sakura-madoromi/TetherLock/docs/design/v3-procurement-status.md

> 当前已升级为 **V3-purchased-specs-1**：M4×55电机、侧壁R16按钮、3mm绑带槽；霍尔和磁铁取消。以下是旧版记录，当前规格和未完成接口以[现购物料适配说明](v3-purchased-specs.md)及当前BOM为准。

# V3 plan1 采购资料与待解决项目

工程数据版本：V3-plan1.1；CAD指纹：`d1dc445e5ce543239a1012be095a35d1c04742943b300b049524b15deb2aeb14`。精确生成时间和数据指纹见`generated/v3/engineering/data.json`、CSV标题与蓝图标题栏。

主表：`hardware/v3/engineering/materials.json`；紧固件型号和数量从 `hardware/v3/cad/hardware.scad` 的配置导出。`docs/design/v3-bom.csv` 是生成后的完整CSV，含版本与指纹；不得手工改CSV数量。

设备装机估算 **215.95元**，采购整包 **274.50元**，工具与外置充电器 **178.00元**。2026-10-02已观察主控及单节电池座SKU报价并更新，其余主配置金额仍为估算；运费另计。外包打印仍待报价。可靠资料候选不能满足约100元目标，不能宣称已达预算。

## 2026-10-02 实际商品核查

按1套样机、寄云南个旧或蒙自核算；页面仅验证寄个旧。六项低价候选优惠前合计38.78元，单项运费共8元；整套条件替代情景装机109.73元、整包168.28元，其他零件报价和运费仍有缺口。新电芯候选亿纬25P平头2500mAh，11元寄个旧包邮；原DW01A保护切断可能低于其2.5V下限，须重新选型。稳压25×14.5×4.5mm、OLED25.2×26mm/1315及DRV8833红板均有适配或接线差异，不能视作原模型已适配。

具体SKU、公开尺寸/原理图、接线差异、各项目待核条件及省运费安排见 [采购核查记录](../reviews/v3-procurement-review-2026-10-02.md)、[逐项采购审计CSV](../reviews/v3-procurement-audit-2026-10-02.csv)。

## 已找到资料的候选

- 主控稳压候选 [Pololu S7V8F3 #2122](https://www.pololu.com/product/2122/)：输入2.7～11.8V、输出3.3V；裸板约11×17×3mm，可直接焊线。电池低电压时可用电流须按曲线/台架验证；无电池过放和反接保护。预算暂估75元，比原4元增加71元。

- 电机驱动候选 [Pololu DRV8833 #2130](https://www.pololu.com/product/2130)，[板尺寸图](https://www.pololu.com/file/0J1615/drv8833-dual-motor-driver-carrier-dimensions.pdf)：12.7×20.3mm；VM2.7～10.8V。裸板与装排针后的高度不能混用，出线/最高器件还须确认。当前CAD仍是旧15×20×7候选，不能把20.3mm板自动认定适配。

- [TI DRV5032](https://www.ti.com/lit/ds/symlink/drv5032.pdf)：ZE芯片电气条件已核对，但成品小板尚未找到满足安装条件的确定SKU；芯片尺寸不能当成板件尺寸。合盖检测仍须测触发、释放和锁扣可通过范围。

- [Apple 手机技术规格](https://support.apple.com/en-la/125091)和[官方配件尺寸图](https://developer.apple.com/download/files/accessories/dimensional-drawings/iphone-17-pro-max.pdf)用于尺寸参照。`hardware/v3/engineering/references.json`记录主体8.75mm、相机平台2.55mm与玻璃1.88mm，总厚13.18mm。该参照不计设备采购、打印数量或耗材。

## 未解决项目

- **motor**：已取得驰海M3丝杆厂家参考尺寸图及3V45/26型电气参数；对应淘宝SKU未定。45型额定200rpm/堵转≤0.95A、26型额定130rpm；须核对最大12.1mm径向尺寸、0.5螺距及低电池带载。主候选不得视为已验证商品。

- **bridge_board**：板长20.3mm超出旧20mm候选包络0.3mm，局部挡边和焊线空间待适配；人民币估算40元也超出原3元预算。禁止图纸显示已验证装配。

- **hall**：只核对了芯片电气属性，三片现成板件仍未选定。旧8×6/6×6小板不能当作商品尺寸；须补充模块或重新设计支架。

- **ties**：旧CAD绑带槽宽1.5mm；常见2.5mm绑带不适配，需窄带或局部扩槽。

- **battery_protection**：现有电池座实体为74×22×21总包络，没有单列保护板适配证据；不能把芯片面积当板件面积。

- **battery_connector**：配对端一起采购；旧小包络及额定电流尚未实测。不得自动把红线当成正确针位。

- **motor_bulk_cap**：模块现有去耦不能保证电机瞬态，按台架测量决定容量；独立电容安装包络待适配。

- **external_printing**：费用尚未报价，不以0元宣称免费；与设备耗材成本分开。

完整主表、89页机械/电气资料和27步组装指导已实现。未解决项按计划保留具体尺寸、预算或选型冲突；候选硬件包络不表示现货已适配，图纸和步骤禁止将其当作已验证装配。实物记录模板为 `docs/design/v3-physical-acceptance.csv`，测量栏为空。

2026-10-02用户要求改为公开资料核验：停止淘宝登录查询。报告补充五项不需登录的外币公开报价、完整模块核验表、保护参考电路及来源校验；人民币六项SKU观察值仍为同日历史记录，未知合单/蒙自运费未填0。M2嵌件与按钮无确定适配供货型号，已列为未解决。
