sakura-madoromi/TetherLock/docs/reviews/v3-procurement-current-2026-10-02.md

# 现实模块与价格核算：当前采购版 · 2026-10-02

1套样机；白色外壳；云南红河个旧或蒙自；先采购电气台架，紧固件及装壳物料后买。用户决定采用N20 M4×55、绿色无灯两脚无锁R16按钮，取消霍尔；2.5mm绑带槽已修改。仅公开资料及用户截图，不使用淘宝登录会话，不下单、不联系卖家。

本报告替代早前M3/霍尔/Pololu低价候选情景。历史报价保留历史身份；同芯片的不同板不能互相套尺寸、价格或电路。当前完整62行BOM逐项价格身份见[v3-procurement-current-audit-2026-10-02.csv](v3-procurement-current-audit-2026-10-02.csv)。

## 可核对的本次订单小计

截图12项的单价×数量合计恰好**¥81.51**，与底部“立即支付”一致；这不是支付凭证。虽然第三张底部还有“顺手买”入口，可见12项已经算到显示总额，不能据此猜测另有已选商品。

- 删除3颗霍尔：¥81.51−¥4.05=**¥77.46**。
- 面包板2→1、按钮2→1、SM成对线3→1：再省¥3.50+¥1.32+¥1.12=¥5.94，最低可见商品小计**¥71.52**。
- 2P排线截图优惠后¥1.76/m，划线价¥2.51/m，两米优惠差¥1.50。不依赖这项优惠时，减量预算**¥73.02**；保留原数量但删霍尔的预算**¥78.96**。

这里的“最少”仅适用于人工电气台架；若两块面包板和备件更方便，可保留。SM成对线1份只覆盖一个可拆接口，其他连接台架直焊/跳线；若需电机也可拆，要另留一份，增加¥0.56。没有自动操作用户购物车。

| 商品 | 原数量 | 最少台架数量 | 截图单价 | 最少小计 |
|---|---:|---:|---:|---:|
| MB-102 830孔面包板 | 2 | 1 | ¥3.50 | ¥3.50 |
| SM2P 20cm成对线 | 3 | 1 | ¥0.56 | ¥0.56 |
| 1S-4012A(3.7V)保护板 | 1 | 1 | ¥4.95 | ¥4.95 |
| 18650单节带线座 | 1 | 1 | ¥1.32 | ¥1.32 |
| R16-503绿色无灯两脚无锁 | 2 | 1 | ¥1.32 | ¥1.32 |
| DRV5032ZEDBZR裸芯片（取消） | 3 | 0 | ¥1.35 | ¥0.00 |
| DRV8833红板已焊排针 | 1 | 1 | ¥2.46 | ¥2.46 |
| TPS63020 3.3V模块 | 1 | 1 | ¥14.85 | ¥14.85 |
| 0.96寸白色4P OLED | 1 | 1 | ¥10.89 | ¥10.89 |
| ESP32-C3 SuperMini已焊排针 | 1 | 1 | ¥12.65 | ¥12.65 |
| 26AWG黑色2P排线1m | 2 | 2 | ¥1.76 | ¥3.52 |
| N20 M4×55 3V 150rpm带法兰螺母 | 1 | 1 | ¥15.50 | ¥15.50 |

优信原订单¥62.49，删霍尔后¥58.44，按上述减量为¥52.50；萨牛两米线¥3.52；德弘电机¥15.50。三店在原截图均显示包邮。地址未展开，未证明选择的是个旧还是蒙自，也未确认删减后包邮门槛。最终到手价为商品小计+修改后的实际运费+未购补件；未知运费不填0。退货运费险为可选项，不当作必购硬件费用。

## 还不在这个小计里的东西

截图没有展示18650电芯、独立单节锂电充电器、杜邦跳线、USB-C数据线、驱动电源端100µF≥10V电容。已有工具/线材可复用；未知价格暂不编造。三个机械到位开关、触发支架属于后续机构验证，不是当前已完成的检测子系统。不要为了买几毛钱补件再付一笔运费，优先同店并单；新增店铺只有货价节省超过新增运费及必要适配费用才值得拆单。

## 尺寸与电路核查结论

| 模块 | 已有证据 | 当前结论/剩余核对 |
|---|---|---|
| N20 M4×55 | 用户德弘尺寸图：M4、牙距0.7、轴55±1、截面12×10、轴偏置2.5 | 本体文字16+9与图15+9/24.5不一致，CAD取25mm保守包络；前视Ø3也与正文M4矛盾。150rpm负载定义/堵转电流/自锁仍待测。 |
| 配套法兰螺母 | 截图写“带法兰螺母”，没有尺寸 | 不是已核定AF7/Ø10/厚5。其他供应商有Ø22×12、四M3孔的M4联轴法兰件，不能自动套用，也不能把候选六角座当已适配。实际配套件须量尺寸和安装孔。 |
| R16-503两脚无锁 | 用户图Ø17.8、本体18.3、端子6、外端5.7；同系列供应商公开φ16安装 | CAD侧壁凹入候选孔Ø16.4；实际螺纹/螺母与3mm面板夹持待确认。常开按下闭合；不接LED电源。 |
| ESP32-C3 SuperMini已焊排针 | 确定采购型号与报价；Nologo公开参考原理图 | 实际板是否同版、排针总高和USB/3V3反灌未证明；先USB台架，装壳需量或去排针。 |
| TPS63020固定3.3V | 选项截图；TI芯片手册/参考电路 | 不能借用另一家25×14.5或Pololu尺寸。优信公开索引找到5V款，未得到本3.3V板完整图。EN/PS接法及低电量瞬态待核。 |
| DRV8833红板已焊排针 | 截图选择与TI芯片原理 | 不沿用Pololu的FLT/SLP端子和默认上拉。真实封装、板端STBY连通、限流、起动/堵转及板尺寸未核。PW持续额定低于PWP/RTY；不能用“2A峰值”证明持续能力。 |
| OLED 0.96白色4P | 截图所选规格和报价 | 不能套用之前另一店SSD1315/25.2×26尺寸；确认3.3V、I2C脚位、地址、控制器和PCB/排针高度。 |
| 1S-4012A(3.7V) | 截图选项明确3.7V | 公共搜索存在同名3.2V磷酸铁锂和3.7V锂离子版本；不凭型号猜保护芯片/电流。需核对所选板的过充/过放阈值、容差、恢复、B/P端和外形。 |
| 18650座与SM2P | 选项/报价；接口类型可区分 | 座含电芯/弹簧/出线尺寸待测。SM2.54并非原JST-SH1.0；对插极性、线径、接触电流与装壳包络待核。 |
| 2.5mm绑带/连续钢轴 | 当前CAD实体测试和用户规格 | 槽3mm且贯通；钢轴仍Ø2×180连续，买长棒切断。AB胶短轴拼接不能替代。 |

完整卖家板级原理图尚未取得。TI/Nologo参考电路是核对依据，不是证明所购板完全同版。当前逻辑计划保留GPIO0/1显示、GPIO3/4/5待选机械触点、GPIO6按钮、GPIO7/10驱动输入；真实丝印/焊盘须核对。电机独立支路，共地；首次USB主控调试不同时外供3V3，保护B−不旁路到系统地，保护板也不代替充电器。

## 当前整机估算与本次订单的区别

已将用户最新截图对应的主控、稳压、驱动、显示、座、保护板、接头、排线价格写入物料主表，替换旧候选价格；没有将旧Pololu板当作¥14.85的TPS63020。原主表装机估算¥208.37已变为**¥122.47**，整包估算**¥163.74**，均不含未知运费和外包打印费；工具及独立充电器仍为估算¥178.00，已有可复用。

这不是完整成品到手报价：机械耗材/电芯/工具仍有未报价项，打印耗材按旧用量估算；机械反馈数量当前为0，后续开关/支架费用未加入。屏幕、主控等有报价不等于装壳适配完成。不能用¥71.52台架小计宣称100元完整产品已达标。

## 公开来源与证据

- 用户截图：[订单1](../../assets/evidence/reviews/v3-current-procurement-evidence/s3if18a7.webp)、[订单2](../../assets/evidence/reviews/v3-current-procurement-evidence/p8f6gmau.webp)、[订单3](../../assets/evidence/reviews/v3-current-procurement-evidence/a80znaro.webp)；[按钮尺寸](../../assets/evidence/reviews/v3-purchased-specs-evidence/bw1v2lpe.webp)、[电机尺寸](../../assets/evidence/reviews/v3-purchased-specs-evidence/xv97n9y4.webp)。未保存账号资料或访问登录会话。
- [Finglai R16-503B](https://www.finglai.com/products/switches/push-buttons/DIA16-R/R16-503B.html)：φ16、复位(ON)-OFF同系列参考；其寿命/电流参数不能代替优信实物。
- [优信TPS63020 5V目录](https://www.yourcee.com/productinfo/875179.html)：只找到另一输出选项的公开索引，未取得3.3V所选板完整电路/尺寸。
- [Tempero M4 flange coupling nut](https://temperosystems.com.au/products/m4-flange-coupling-nut/)：不同供应商给22mm外径、12mm高度、四M3孔，且标用于N20 M4×55。仅用于指出螺母形态不唯一，未采用其外币报价或套入德弘型号。
- [TI DRV8833](https://www.ti.com/lit/ds/symlink/drv8833.pdf)、[TI TPS63020](https://www.ti.com/lit/ds/symlink/tps63020.pdf)、[Nologo主控参考电路](https://github.com/NologoTech/ESP32C3-Supermini/tree/main/Hardware)。

当前几何1148项通过，价格审计与CAD核验范围分开。实际法兰螺母、保护板参数、所选板包络/完整板图、机械开关与最终云南运费仍未证明。报告明确保留这些缺口；目前不把“现实模块规格全部核实”的目标标为完成。
