sakura-madoromi/TetherLock/docs/superpowers/plans/2026-10-01-v3-cad.md

# TetherLock V3 CAD Implementation Plan

> **For agentic workers:** Execute inline in the authorized workspace. Checkpoints below replace a separate execution handoff because the user explicitly requested CAD generation. No commit, branch mutation or publication is requested.

**Goal:** Deliver an inspectable V3 structural CAD prototype, printable part exports, complete provisional hardware envelopes, and reproducible geometry checks.

**Architecture:** New independent `hardware/v3/cad/` subtree. Offset M3 screw moves a nut carriage whose finger engages a laterally floating fork on a solid bolt. A keyed guide supports the bolt independently. An isolated battery compartment opens underneath the main lock box.

**Tech Stack:** OpenSCAD CLI, Python standard library, SVG/PNG previews.

**Spec:** `docs/design/v3-proposal.md`, current design baseline; unresolved acceptance items are tracked in `docs/design/v3-purchased-specs.md`.

## Global Constraints

- Closed overall envelope 240×120×55 mm including hinge.
- Target object envelope 185×95×40 mm and removal path.
- No external USB or internal charger; removable 18650 and separate charger.
- Unlock confirmation ≤15 seconds is a physical acceptance requirement, not proven by CAD.
- Approximately RMB 100 with a small overrun allowed; procurement prices checked later by user.
- Hardware that has no frozen SKU must be labelled provisional; no strength or manufacture-release claim.
- V3 is the only maintained CAD and export baseline; old version sources and exports are not part of the current tree.

## File boundaries

- `hardware/v3/cad/params.scad`: shared dimensions and assembly interfaces.
- `hardware/v3/cad/enclosure.scad`: shell, lid, battery cover, latch, retainers.
- `hardware/v3/cad/lock.scad`: module base, guide, solid bolt, floating drive, motor clamp.
- `hardware/v3/cad/electronics.scad`: removable electronics carrier and retainers.
- `hardware/v3/cad/hardware.scad`: provisional purchased part envelopes and fasteners.
- `hardware/v3/cad/assembly.scad`: part dispatch, assembled/open/exploded and printable views.
- `scripts/v3/export_verify.py`: fresh exports, topology, pairwise interference, motion, storage and negative controls.
- `docs/design/v3-cad.md`, `v3-bom.csv`: dimensions, assembly, print placement and unresolved hardware/physical checks.

## Task 1: Acceptance harness before CAD

- [x] Write the export/verification entry point with an assertion that the assembly source exists.
- [x] Run `python3 scripts/v3/export_verify.py --quick` and observe the missing-V3-source failure.
- [x] Define real exported mesh assertions: positive volume, closed edges, connected exterior surface; closed assembly within target envelope; zero unplanned collisions.

## Task 2: Mechanical modules

- [x] Implement shared parameters and independent part dispatch.
- [x] Use an 8 mm OD hinge inside the closed envelope with fixed rear header and relief for moving knuckles.
- [x] Implement removable battery maintenance cover, fixed compartment isolation, and hardware component extraction clearance.
- [x] Implement latch T head, inside retainer, replaceable neck, and solid 6 mm bolt with a keyed guide and floating drive connection.
- [x] Export every part using `python3 scripts/v3/export_verify.py --quick`; fix actual collision/connectivity failures before adding previews.

## Task 3: Complete assembly and provisional hardware

- [x] Add motor, threaded shaft, captive nut, cell/holder, ESP, OLED, regulated power and H bridge, three detection envelopes, button, acrylic, hinge pin and fasteners.
- [x] Add removable electronics supports with fasteners and wire routing holes; no floating clips.
- [x] Check actual assembly pairs at release and locked endpoints and intermediate travel. Check a 0.25 mm loaded-bolt displacement does not contact the screw/drive finger; a 0.35 mm displacement must contact its guide.

## Task 4: Export, motion and documentation

- [x] Run `python3 scripts/v3/export_verify.py` for fresh source exports, full closed-pair checks, opening samples to 105°, object insertion/removal and battery extraction.
- [x] Run negative controls for opening while locked and the geometry checker against an intentionally obstructed pose; record evidence rather than silently ignore errors.
- [x] Render assembled, open, exploded and lock close-up PNG from the same assembly file.
- [x] Write BOM, assembly and print instructions, dimensions and limits. Include minimum printer bed footprint and physical qualification checks.
- [x] Check docs, source/export manifest and V2 hashes; deliver as a structural prototype with the specific validation scope.

## Completion evidence

- Main fresh export run: 1,034 checks, zero failures (`generated/v3/verification.json`).
- Independent review additional drive-group checks: 10, zero failures; reproducible via `scripts/v3/verify_review.py`.
- 21 printable STL types / 23 assembled printable pieces; exact closed bounds 240×120×55.
- All 23 preserved V2 source/export hashes unchanged.
- Structural prototype only: printer supports, purchased SKUs, actual tolerances/strength, electronics/firmware and loaded low-voltage unlock ≤15 s still need physical qualification.
