sakura-madoromi/TetherLock/docs/superpowers/plans/2026-10-01-v3-viewer.md

# V3 Preview Workbench Implementation Plan

User explicitly requested direct implementation without brainstorming. Execute inline in the authorized workspace; no commit or publication. Existing historical HTML and V3 CAD remain intact.

**Goal:** A polished local Vite workbench using actual verified V3 geometry, with reliable motion and reusable preview/engineering exports.

**Architecture:** Vanilla JavaScript modules with Three.js, generated public assets and provenance manifest. Keep UI, CAD transforms, rendering, drawing projection and file export separate. Engineering drawings use actual transformed mesh geometry; they are reference projections, not manufacturing drawings or a replacement for CAD.

**Files:** root `package.json`, `vite.config.js`; `viewer/index.html`, `apps/workbench/src/{main,scene,state,drawing,exports,icons}.js`, `apps/workbench/src/style.css`; `scripts/v3/viewer_assets.py`; `tests/workbench/{state,drawing}.test.js`, `tests/workbench/browser.mjs`; `docs/design/v3-viewer.md`.

- [x] Write and run failing motion/transform/drawing tests. Catch lid opening before bolt release, wrong hinge axis, and incorrect measured drawing dimensions.
- [x] Generate release-pose assets from verified CAD exports and metadata; include source SHA256 and real hardware/fastener geometry. Refuse stale verified sources.
- [x] Implement scene: Z-up CAD coordinates, fixed hinge pivot, Y-only drive stroke, distinct explosion offsets, part selection/visibility/isolation, clipping, rulers and framing.
- [x] Build responsive workbench UI: assembly/engineering modes, part browser, motion timeline, material/camera presets, selection inspector and export controls.
- [x] Implement actual mesh-derived orthographic SVG drawing with sampled depth visibility and measured dimensions; PNG and browser print/PDF. Label current pose, visible-part extent and scale.
- [x] Implement clean 2K/4K PNG including transparent background, multi-view ZIP, WebM movement recording, GLB in meters, saved views and JSON view settings.
- [x] Run node tests, Vite production build and real Chromium browser checks: asset load, picking, motion, clipping, drawings, downloads, recording, mobile layout and offline/static build.
- [x] Request independent code review, fix material findings, document commands/limits and leave local preview running. Package static build and verification evidence.

Validation evidence: `generated/v3/viewer-verification.json`, real downloaded examples in `generated/v3/viewer-static/`, and `docs/reviews/v3-viewer-review-2026-10-01.md`. Static bundle includes all models and downloads with relative URLs. Browser regressions also cover rounded silhouettes, damaged camera imports, pose changes during exports, recording interruptions, and narrow-screen framing.
