sakura-madoromi/TetherLock/docs/design/v3-plan1-delivery.md

> 当前已升级为 **V3-purchased-specs-1**：M4×55电机、侧壁R16按钮、3mm绑带槽；霍尔和磁铁取消。以下是旧版记录，当前规格和未完成接口以[现购物料适配说明](v3-purchased-specs.md)及当前BOM为准。

# plan1 工程资料交付记录

本次已交付V3-plan1.1工程工作台、CAD/STL和机械/电气资料。采购与局部模块适配按plan1 §2.3的条件分支处理：完整现货包络、预算或检测条件不能确认时，输出具体冲突并保持未解决状态。此交付不等于全部模块已选定或实物已经合格。

| 计划范围 | 已交付内容与证据 |
|---|---|
| §2.1 共用数据 | engineering目录主表；44个产品对象、69行物料、35个稳定紧固连接；数量、特征与引用审计 |
| §2.2 无窗垫结构 | 内栅接触面Z47.4～50.5、固定耳Z47.4～49.9；149×82×1.5窗片；栅窗31项检查 |
| §2.3 模块采购 | 主候选、资料来源、关键条件及8项具体未解决项目；见v3-procurement-status.md；未知包络没有伪装为已适配 |
| §3.1 尺寸参照 | 独立本地手机/虚构卡模型与开关；图片/录制按可见状态；GLB选择包含参照；制造资料排除参照 |
| §3.2 物料 | 完整/采购/打印/工具四种CSV；搜索、分类、数量切换、费用分组与跨页面链接 |
| §3.3～3.5 蓝图 | 41个主题扩展88页；固定制造姿态、真实闭合截面、CAD名义孔位/台阶、热熔方向/深度/余料、打印方向/支撑/备件 |
| §3.6 电气 | 电源/逻辑GPIO/端子/线束/台架资料，38条逐线记录；实际模块焊盘与接头物理针序保留收货确认条件 |
| §3.7 导出 | 实际SVG、3840px PNG、A3 PDF、整套ZIP；本地可嵌入中文字体；1:1亚克力SVG/DXF与100mm校验线 |
| §4 组装指导 | 22装配+5维护步骤；独立场景/相机、已验证路径与操作示意区分、手动检查、版本进度/旧记录/JSON/重置/禁用存储回退 |
| §5 验证和交付 | 当前源码几何、数据、浏览器及包指纹证据；静态HTTP子目录离线使用；实物记录模板保持空白 |

CAD名义几何检查通过1078项整机、31项栅窗、81项铰链/霍尔、10项附加驱动、33项参照及6项连续安装路径检查。整盖/锁驱动的既有采样检查与连续安装扫掠分别标识；几何证据不证明保持力、运动寿命或电气性能。

工程资料审计通过458项检查，71条真实剖面路径闭合。桌面浏览器四个套件分别通过19、7、7、21组；静态HTTP子目录两套件分别通过19、21组。浏览器报告包含当前源指纹。19项单元测试通过。实际输出文件及三个ZIP的逐文件一致性以当前三个交付包内的清单为准。

设备装机估算216.95元、整包采购275.50元、工具与外置充电器178元；均非报价，外包打印另待报价。约100元目标未达。电机、驱动板、三片霍尔板、绑带、电池保护、配对接头、补充电容与外包打印仍为未解决项目，具体冲突见采购状态文档及BOM。

用户可从同一份资料找到采购规格、打印文件、尺寸依据、装配顺序、逐步检查和待测项目。实际模块适配仍需供货尺寸/实物；电气引脚是带板型核对条件的逻辑接线要求。实物强度、霍尔触发/释放、低电压、开合寿命与≤15秒开锁没有通过声明。控制固件属于后续独立任务。
