sakura-madoromi/TetherLock/docs/reviews/v3-viewer-review-2026-10-01.md

# V3 工作台独立代码审查

2026-10-01，按 requesting-code-review 技能由只读审查代理完成。审查对象为当前未提交的 `apps/workbench/src`、资源生成脚本、Vite 配置与测试；没有修改 CAD 和历史预览。最终结论：没有遗留的严重或重要缺陷，可以交付。

| 发现 | 修复与验证 |
| --- | --- |
| 相机导入接受空数组，使三维坐标变成 undefined | 三元有限向量、有效距离、缩放和投影范围校验；修改姿态前验证；单元与浏览器回归 |
| 平滑圆角/圆柱没有锐边，工程图丢失外轮廓 | 增加随视向变化的邻面轮廓；覆盖平行视线退化情况；两种圆柱分段角度回归 |
| 五视图导出期间允许修改姿态，导致图片与配置不一致 | 固定姿态、镜头、选件、画布交互；覆盖书签和局部事件入口；浏览器中途改栓行程被阻止 |
| 录制中切工程视图/手动姿态/暂停/加载书签停止运动，却不停止录像 | 录制期间保留镜头操作，防止这些操作中断完整周期；浏览器确认仍自动结束并生成 WebM |
| GLB 测试只认 scale 字段，误报正确的 matrix 缩放 | 检查根节点缩放矩阵或 scale，并核对 base_box 的 0.24×0.12×0.055 m 包络 |
| 桌面切换到窄屏时沿用相机距离，模型部分裁出画面 | 显著缩窄视口时重新构图，隐藏画布和图片导出时跳过；浏览器验证闭合包络八个角投影完整留在390 px画面 |

审查另核对了 CAD 的 +X 铰链轴、+Y 锁栓行程、储物验收块位置、工程视图真实投影尺寸、源文件指纹链条和 GLB 米单位。审查代理独立运行最新单元测试，9/9 通过。实际浏览器交互和下载文件由主代理验证，结果见 `generated/v3/viewer/browser-results.json`。

实物强度、摩擦、电机扭矩、开锁时间和供应商尺寸属于后续样机验证；本次工作台不将几何动画作为这些性能的验证依据。
