sakura-madoromi/TetherLock/docs/reviews/v3-window-grille-review-2026-10-01.md

# V3 双层同色防护栅窗独立审查

按 requesting-code-review 技能，由只读审查代理检查 `hardware/v3/cad` 的新栅窗及资源生成链条。用户已确认内外双栅夹窗片，内外栅栏与外壳同色同耗材。结论：未发现关键或重要结构缺陷，本次CAD变更可接受。

| 独立检查 | 证据 |
| --- | --- |
| 上下软垫实际实体支承 | 将软垫投影移入相邻栅栏0.3 mm后，差集为空 |
| 四耳硬限位 | +0.2 mm探针交集体积约75.591 mm³，对应接触面积约377.96 mm² |
| 网格可打印性 | 顶盖与内栅均单连通、封闭，无非流形边与退化三角；内栅打印Z=0～2.5 |
| 沉头螺钉与盲孔 | 头朝盒内、杆朝+Z；杆端53.4、进入导孔3.5、孔底余量0.8、外表面余料0.8；不碰亚克力 |
| 内侧工具与维护路径 | 主盖105°时4 mm工具通道可接近；栅窗组向内移出80 mm无碰撞 |
| 预览与生成件 | 新内栅/窗片/软垫均随盖运动；内外栅与壳同色；过期四压片网格会移除 |

30项栅窗专项检查通过，见 `generated/v3/window/verification.json`。独立探针保存在本审查记录旁的 `v3-window-grille-evidence/`。主代理另执行完整整机几何验证、附加驱动检查和浏览器回归；最终证据以更新后的生成报告为准。

本结论针对名义几何。软垫压缩量、打印螺纹保持力、栅条抗弯、窗片抗冲击和实物开锁性能仍需样件验证。
