sakura-madoromi/TetherLock/docs/superpowers/plans/2026-10-01-plan1.md

# V3 Plan 1：初始计划索引

本文件原先保存了与工程工作台实施计划大段重复的初始任务清单。完整的目标、约束、实现步骤和后续完成状态统一维护在 [工程工作台实施计划](2026-10-01-plan1-engineering-workbench.md)。

初始计划中的任务尚未勾选；后续实施计划增加了完成状态与未解决限制，两者不是同一次验收。需要引用初始措辞时，使用[已发布基线中的冻结原文](https://github.com/sakura-madoromi/TetherLock/blob/95086fa086710571b39ede804c02a39de307ba05/docs/superpowers/plans/2026-10-01-plan1.md)。本次目录治理的完整本地备份也保留了原文。
