sakura-madoromi/TetherLock/docs/reviews/v3-hinge-hall-evidence/continuous_pin_service.scad

include <../../../hardware/v3/cad/assembly.scad>
view="metadata";
lid_angle=105; intersection(){xrod(-357,hinge_y,hinge_z,2,680);named("pin_service_surround");}
