sakura-madoromi/TetherLock/docs/reviews/v3-hinge-hall-evidence/keepers_pin_nominal.scad

include <../../../hardware/v3/cad/assembly.scad>
view="metadata";
intersection(){hinge_pin();hinge_guard(-1);}
