sakura-madoromi/TetherLock/docs/reviews/v3-hinge-hall-evidence/keepers_pin_radial_front_021.scad

include <../../../hardware/v3/cad/assembly.scad>
view="metadata";
intersection(){translate([0,.21,0])hinge_pin();union(){hinge_guard(-1);hinge_guard(1);}}
