sakura-madoromi/TetherLock/docs/reviews/v3-hinge-hall-evidence/keeper_driver.scad

include <../../../hardware/v3/cad/assembly.scad>
view="metadata";
lid_angle=105; keeper_tool_conflicts();
