sakura-madoromi/TetherLock/docs/reviews/v3-hinge-hall-evidence/base_box.scad

include <../../../hardware/v3/cad/assembly.scad>
view="metadata";
named("base_box");
