sakura-madoromi/TetherLock/docs/reviews/v3-hinge-hall-evidence/base_installed_extra.scad

include <../../../hardware/v3/cad/assembly.scad>
view="metadata";
difference(){base_box();let($print_bores=true)base_box();}
