sakura-madoromi/TetherLock/docs/reviews/v3-hinge-hall-evidence/base_print_extra.scad

include <../../../hardware/v3/cad/assembly.scad>
view="metadata";
difference(){let($print_bores=true)base_box();base_box();}
