sakura-madoromi/TetherLock/docs/reviews/v3-hinge-hall-evidence/hinge_guard_right.scad

include <../../../hardware/v3/cad/assembly.scad>
view="metadata";
named("hinge_guard_right");
