sakura-madoromi/TetherLock/docs/reviews/v3-hinge-hall-evidence/item_post_clearance.scad

include <../../../hardware/v3/cad/assembly.scad>
view="metadata";
intersection(){base_box();named("item");}
