sakura-madoromi/TetherLock/docs/reviews/v3-hinge-hall-evidence/keeper_insert_coupon.scad

include <../../../hardware/v3/cad/assembly.scad>
view="metadata";
print_part("keeper_insert_coupon");
