sakura-madoromi/TetherLock/docs/reviews/v3-hinge-hall-evidence/left_cheek_slice.scad

include <../../../hardware/v3/cad/assembly.scad>
view="metadata";
intersection(){hinge_guard(-1);translate([-109.1,-56,50])cube([2,2,2]);}
