sakura-madoromi/TetherLock/docs/reviews/v3-hinge-hall-evidence/lid.scad

include <../../../hardware/v3/cad/assembly.scad>
view="metadata";
named("lid");
