sakura-madoromi/TetherLock/docs/reviews/v3-hinge-hall-evidence/lid_installed_extra.scad

include <../../../hardware/v3/cad/assembly.scad>
view="metadata";
difference(){lid();let($print_bores=true)lid();}
