sakura-madoromi/TetherLock/docs/reviews/v3-hinge-hall-evidence/lid_print_extra.scad

include <../../../hardware/v3/cad/assembly.scad>
view="metadata";
difference(){let($print_bores=true)lid();lid();}
