sakura-madoromi/TetherLock/docs/reviews/v3-hinge-hall-evidence/right_cheek_slice.scad

include <../../../hardware/v3/cad/assembly.scad>
view="metadata";
intersection(){hinge_guard(1);translate([73.4,-56,50])cube([2,2,2]);}
