sakura-madoromi/TetherLock/docs/reviews/v3-hinge-hall-evidence/window_insert_coupon.scad

include <../../../hardware/v3/cad/assembly.scad>
view="metadata";
print_part("window_insert_coupon");
