sakura-madoromi/TetherLock/docs/reviews/v3-window-grille-evidence/four_stop_contact.scad

include <../../../hardware/v3/cad/assembly.scad>
view="metadata";
intersection(){lid();translate([0,0,.2])window_grille();}
