sakura-madoromi/TetherLock/docs/reviews/v3-window-grille-evidence/inner_pad_fully_supported.scad

include <../../../hardware/v3/cad/assembly.scad>
view="metadata";
difference(){translate([0,0,-.3])window_pad_bottom();window_grille();}
