sakura-madoromi/TetherLock/docs/reviews/v3-window-grille-evidence/window_fasteners_in_pane.scad

include <../../../hardware/v3/cad/assembly.scad>
view="metadata";
intersection(){acrylic();lid_fasteners();}
