sakura-madoromi/TetherLock/docs/reviews/v3-window-grille-evidence/window_install_minus80.scad

include <../../../hardware/v3/cad/assembly.scad>
view="metadata";
lid_angle=105;window_raise=-80;intersection(){named("window_install");named("window_service_surround");}
