sakura-madoromi/TetherLock/(list of files, cad)

Other CAD files:
assets/cad/v3/assembly/base_box.stl
assets/cad/v3/print/fit_gauge.stl
assets/evidence/reviews/v3-hinge-hall-evidence/hinge_guard_left.stl
assets/evidence/reviews/v3-window-grille-evidence/blind_roof.stl
assets/cad/v3/assembly/battery_hatch.stl
assets/cad/v3/print/window_grille.stl
assets/evidence/reviews/v3-hinge-hall-evidence/keeper_insert_coupon.stl
assets/evidence/reviews/v3-window-grille-evidence/four_stop_contact.stl
assets/cad/v3/assembly/window_grille.stl
assets/cad/v3/print/fit_bar.stl
assets/evidence/reviews/v3-hinge-hall-evidence/base_box.stl
assets/cad/v3/assembly/acrylic.stl
assets/cad/v3/print/hinge_bore_coupon.stl
assets/evidence/reviews/v3-hinge-hall-evidence/item_post_clearance.stl
assets/cad/v3/assembly/esp.stl
assets/cad/v3/print/esp_clip.stl
assets/evidence/reviews/v3-hinge-hall-evidence/right_cheek_slice.stl
assets/cad/v3/assembly/oled.stl
assets/cad/v3/print/electronics_tray.stl
assets/evidence/reviews/v3-hinge-hall-evidence/left_cheek_slice.stl
assets/cad/v3/assembly/upper_clip.stl
assets/cad/v3/print/lock_base.stl
assets/evidence/reviews/v3-hinge-hall-evidence/window_insert_coupon.stl
assets/cad/v3/assembly/fasteners_fixed.stl
assets/evidence/reviews/v3-hinge-hall-evidence/lid.stl
assets/cad/v3/assembly/upper_deck.stl
assets/cad/v3/print/latch_retainer.stl
assets/evidence/reviews/v3-hinge-hall-evidence/hinge_guard_right.stl
assets/cad/v3/assembly/lid.stl
assets/cad/v3/print/lid.stl
assets/evidence/reviews/v3-hinge-hall-evidence/keeper_direct_lift.stl
assets/cad/v3/assembly/hinge_guard_right.stl
assets/cad/v3/print/insert_coupon.stl
assets/evidence/reviews/v3-hinge-hall-evidence/base_print_extra.stl
assets/cad/v3/assembly/fasteners_lid.stl
assets/cad/v3/print/latch.stl
assets/evidence/reviews/v3-hinge-hall-evidence/lid_print_extra.stl
assets/cad/v3/print/guide_cap.stl
assets/evidence/reviews/v3-hinge-hall-evidence/keeper_lift_half_steps.stl
assets/cad/v3/assembly/motor_pads.stl
assets/cad/v3/print/window_insert_coupon.stl
assets/evidence/reviews/v3-hinge-hall-evidence/keeper_half_steps.stl
assets/cad/v3/assembly/inserts_lid.stl
assets/cad/v3/print/hinge_guard_right.stl
assets/cad/v3/assembly/electronics_tray.stl
assets/cad/v3/print/keeper_insert_coupon.stl
assets/cad/v3/assembly/guide_cap.stl
assets/cad/v3/print/upper_clip.stl
assets/cad/v3/assembly/latch_retainer.stl
assets/cad/v3/assembly/bridge_board.stl
assets/cad/v3/print/upper_deck.stl
assets/cad/v3/assembly/hinge_guard_left.stl
assets/cad/v3/print/oled_bridge.stl
assets/cad/v3/assembly/battery_connector.stl
assets/cad/v3/assembly/esp_clip.stl
assets/cad/v3/print/hinge_guard_left.stl
assets/cad/v3/assembly/inserts_fixed.stl
assets/cad/v3/print/base_box.stl
assets/cad/v3/assembly/battery_holder.stl
assets/cad/v3/print/battery_hatch.stl
assets/cad/v3/assembly/button.stl
assets/cad/v3/print/motor_clamp.stl
assets/cad/v3/assembly/oled_bridge.stl
assets/cad/v3/assembly/hinge_pin.stl
assets/cad/v3/assembly/fasteners_drive.stl
assets/cad/v3/assembly/lock_base.stl
assets/cad/v3/assembly/latch.stl
assets/cad/v3/assembly/motor.stl
assets/cad/v3/assembly/board_pads.stl
assets/cad/v3/assembly/motor_clamp.stl
assets/cad/v3/assembly/power_board.stl
assets/cad/v3/assembly/bolt.stl
assets/cad/v3/assembly/drive_nut.stl
assets/cad/v3/assembly/nut_cap.stl
assets/cad/v3/assembly/nut_carriage.stl
assets/cad/v3/print/bolt.stl
assets/cad/v3/print/nut_cap.stl
assets/cad/v3/print/nut_carriage.stl
