sakura-madoromi/TetherLock/docs/validation/product-render.md

# TetherLock V3 产品展示渲染

白色外壳，浅灰摄影棚背景。静态图为 3840×2160 PNG；动画为 1920×1080 VP9 WebM，包含实际解码帧数和时长记录。

## 静态图

- `01-closed-hero.png`：闭合产品主视觉
- `02-open-with-phone-card.png`：开盖展示手机与银行卡尺寸参照
- `03-open-top-layout.png`：开盖俯视布局
- `04-hinge-and-pin.png`：铰链与销轴背面视角
- `05-exploded-assembly.png`：分层爆炸总装
- `06-internal-mechanism-xray.png`：X射线内部机构展示
- `07-grille-window-detail.png`：栅窗与亚克力细节
- `08-oled-and-button-detail.png`：屏幕与按键细节

## 动画

- `09-opening-cycle-1080p.webm`：退栓、开盖停留、闭盖与上锁的完整循环。
- `10-open-close-detail-1080p.webm`：分别展示开盖和闭盖动作。

模型来自 V3 CAD 工作台；手机与虚构银行卡作为独立尺寸参照显示。动画用于产品动作展示。

## 输出归属

以上图像、动画和展示 ZIP 属于生成产物，默认输出到 `generated/v3/product-render/` 并忽略。需要长期保存的验收证据显式归档到 `assets/evidence/`，不要提交整个渲染目录。
