sakura-madoromi/TetherLock/docs/reviews/v3-cad-validation-repair-list-2026-10-02.md

# V3 CAD 验证与修复清单

日期：2026-10-02
对象：`hardware/v3/cad/*.scad` 当前版本；CAD 指纹 `d1dc445e5ce543239a1012be095a35d1c04742943b300b049524b15deb2aeb14`。
范围：几何、装配、运动净空、打印姿态及外购件包络。此文件记录待办；本轮未修改 CAD。

## 结论

当前名义几何没有复现出实体网格错误或已建模零件的明确碰撞：整机新鲜导出验证 **1078 项、0 失败**；栅窗 **31 项、0 失败**；铰链/霍尔 **81 项、0 失败**；独立驱动运动复核 **10 项、0 失败**；参照件包络 **33 项、0 失败**。组装指导中六条刚体安装/维护路径以 Minkowski 薄段扫掠检查，**6 项、0 失败**。当前工程数据审计 **458 项、0 失败**，包含 **71 条闭合剖面路径**。

这说明当前名义网格和列出的检查姿态自洽，不证明未定型号外购件适配，也不证明 FDM 首件强度、孔位配合、霍尔触发或带载开锁合格。整盖 0～105°、锁驱动行程及若干组件装入仍以离散姿态检查；连续安装扫掠的六项结果不覆盖这些整机运动。

## 待处理清单

下表状态均为“待处理”，没有在本轮实施修改。P1 表示冻结采购/装配版 CAD 前需关闭；P2 表示首件打印或机械定版前需关闭；P3 表示可在首件后依测量结果修订。

| ID / 优先级 | 发现与证据 | 建议修复或关闭方式 | 验收条件 |
|---|---|---|---|
| CAD-R01 / P1 | **N20 电机包络没有对应确定 SKU。** [electronics.scad](../../hardware/v3/cad/electronics.scad) 用 12×26×10 mm 电机块和 33.6 mm 轴长；[lock.scad](../../hardware/v3/cad/lock.scad) 的电机托槽、U 槽和压板依赖该包络。它们是候选尺寸，不是收货件尺寸。 | 采购前确认电机外形图、轴/丝杠长度、端子和线材出线、启动/堵转电流；按实物更新电机窝、压板、轴承/轴向限位及走线空间。 | 收货件尺寸及端子包络进入 CAD；退栓与闭锁端点、14 mm 全行程、105° 开盖均无干涉，驱动件可按指导装入并拆出。 |
| CAD-R02 / P1 | **DRV8833 候选与当前简化块不一致。** [hardware.scad](../../hardware/v3/cad/hardware.scad) 将 `bridge_board` 建成 15×20×7 mm。Pololu #2130 厂图标出 PCB 外形 12.7×20.3 mm，板边公差 ±0.3 mm；当前占位块没有说明板边、器件高度、焊点和导线包络。[厂家尺寸图](https://www.pololu.com/file/0J1615/drv8833-dual-motor-driver-carrier-dimensions.pdf) 当前支托垫按15×20 mm绘制，局部挡边、压条和线束空间尚未按该板确认。20.3 mm 比旧的20 mm占位长度多0.3 mm；这是包络差异，现有资料不足以断言整个托盘必然碰撞。 | 冻结驱动板 SKU 和安装方向；将 PCB、最高器件、焊线/排针和弯线半径分别建模，复核托垫、止挡、上层压条及接线可达性。若保持该候选，给 20.3 mm 边长和边缘公差留出装配间隙。 | 用含实物最大包络的 CAD 交集/装入检查通过；插入、固定、拔出和接线均有明确路径，压条能实际限位而不压器件/焊点。 |
| CAD-R03 / P1 | **三处霍尔板均无确定成品板尺寸。** 当前 [electronics.scad](../../hardware/v3/cad/electronics.scad) 的退栓/闭锁板为8×6×1.3 mm，外盖板为6×6×1.8 mm；这些小板包络尚未对应可采购 SKU。铰链/霍尔探针还表明锁舌在0.3°样本无干涉、0.4°样本已干涉，单独的合盖接近信号不能证明锁扣可通过。 | 选择三个实际传感器板件或明确采用裸芯片并设计 PCB；按封装、敏感面、焊盘/导线和胶垫重画座体。让传感阈值与锁舌可通过角度/缝隙共同验收，必要时调整磁铁/传感器位置或增加机械到位检测。 | 三个实际板件完整包络可安装、维护且导线不入运动区；实测合盖报到范围严格落在锁舌无阻通过范围内，并留有打印误差余量。 |
| CAD-R04 / P1 | **绑带槽只有1.5 mm。** [electronics.scad](../../hardware/v3/cad/electronics.scad) 的两条槽为1.5 mm；当前采购说明指出常见2.5 mm绑带不适配。 | 明确采购与装配使用的带宽；若用2.5 mm带，调整槽宽/圆角并检查托盘剩余截面；若保留1.5 mm，BOM 固定窄带规格。 | 实物绑带可穿入并锁紧，槽边无割带/开裂，带扣与相邻电路板及线束不冲突。 |
| CAD-R05 / P1 | **电池保护板、配对接头及电机补充电容没有完整安装包络。** 电池座目前只是 [hardware.scad](../../hardware/v3/cad/hardware.scad) 中的74×22×21 mm总包络；接头是4.3×5×5 mm占位；没有独立保护板及补充电容实体/安装位。 | 选定保护板与电池接头配对件并核对额定电流、极性、封装和线材弯曲；按瞬态台架测量决定是否加电机电容，再安排支架、绝缘、固定和线束通道。 | 所有件以实物最大包络进入 CAD；电池可取出，接头极性可检验，线束避开铰链/锁驱动，电容与保护板不会挤压储物或结构件。 |
| CAD-R06 / P2 | **板件压条名义留有0.3 mm游隙，实际保持力未知。** ESP占位最高Z=14.5，`esp_clip`底面Z=14.8；驱动板占位顶Z=27.3，`upper_clip`底面Z=27.6。名义各留0.3 mm，板件处于下方软垫上；这不构成名义干涉，但没有证明实际板件受压或受振动约束。 | 实物到手后核对 PCB/器件高度、软垫压缩量与压条螺钉止点；按需要调整压条高度或加入有规格的压垫。 | 板件可装拆，无器件/焊点受压；在预定搬运/开合工况下不窜动，连接器和维护针脚保持可达。 |
| CAD-R07 / P2 | **热熔铜螺母邻近的薄壁强度尚未实测。** 独立几何复核读得端盖/电池螺母座最小侧壁约1.375 mm，窗座上方余料1.1 mm；当前试块用于检验该区域，但没有热装、保持力或复拆实测。 | 先按同材质、同方向打印相应嵌件试块并记录热装深度/裂纹/保持力；失败时再增壁厚、扩大承座或调整螺母规格，并重检外形和净空。 | 试块热装和复拆无裂纹、变形或嵌件松脱；确认后的尺寸回填 CAD 并复跑相关实体、工具及窗片净空检查。 |
| CAD-R08 / P2 | **整盖开合与驱动扫掠仍是离散验证。** `export_verify.py` 对盖角使用1°步长并加0.25°/0.5°近闭合点；驱动全行程亦按离散位置检查。薄小碰撞或中间姿态碰撞可能落在采样之间。 | 增加对盖—底壳、盖—锁舌/电路、驱动件—导轨/螺钉等关键运动的连续扫掠或保守 Minkowski 区间检查；对极小净空保持可解释的体积阈值。 | 连续扫掠通过，或每段最小间隙由有界算法证明；故意加入的碰撞负对照能被检查器检出。 |
| CAD-R09 / P2 | **整件外壳打印需要专用平台与切片确认。** 底壳打印平面约240×120 mm，正好等于名义外形；打印说明要求另留裙边/夹具，不能默认在220×220 mm平台上打印。桥接/悬垂说明当前是文字核对项，没有本机切片或首件证据。 | 用目标打印机的有效打印区域、夹具/裙边及禁区实际切片；标记需要支撑的位置、拆支撑通道与桥接失败判据。若用户设备无余量，评估局部结构改版或外包打印，不缩放整机。 | 切片轮廓含必要边缘余量且不触碰机器禁区；首件隔仓、轴孔、锁座和薄壁支撑清理后尺寸与维护路径合格。 |

## 当前已通过的检查

- `scripts/v3/export_verify.py`：全量新鲜导出，1078 项通过，0失败；29种打印件网格闭合/单连通并落床，闭合总装外包络240×120×55 mm。该脚本对整盖运动采样，不是连续扫掠证明。
- `scripts/v3/verify_window.py`：31项通过；窗片、双栅层次、四耳、沉头与离散安装位置。
- `scripts/v3/verify_hinge_hall.py`：81项通过；端盖保持、销轴服务路径及名义霍尔安装几何。磁触发/释放不在 CAD 检查之内。
- `scripts/v3/verify_review.py`：10项通过；驱动组离散位置复核。
- `scripts/v3/verify_references.py`：33项通过；手机/银行卡参照件净空及显示模型尺寸。
- `scripts/v3/verify_assembly.py`：6项通过；钢销、两端盖、内栅/窗片的连续直线服务路径。
- `scripts/v3/verify_engineering.py`：458项通过；数据/特征/接线/步骤引用及71条真实剖面闭合路径。

除历史基线目录外，上述当前报告记录的 CAD 源文件指纹均与工作区一致。当前 CAD 指纹也与 `generated/v3/engineering/data.json` 一致。复跑入口和报告： [整机结果](../../generated/v3/verification.json)、[窗栅结果](../../generated/v3/window/verification.json)、[铰链/霍尔结果](../../generated/v3/hinge-hall/verification.json)、[参照件结果](../../generated/v3/references/verification.json)、[连续装配路径结果](../../generated/v3/assembly-paths/verification.json)、[工程数据审计结果](../../generated/v3/engineering-verification.json)。

## 不属于本清单的验收声明

Pololu #2130 的官方尺寸图支持本表关于其板宽/板长及边缘公差的对照；最终安装仍以实际采购板和焊线为准。[DRV8833 Carrier 尺寸图](https://www.pololu.com/file/0J1615/drv8833-dual-motor-driver-carrier-dimensions.pdf)。外包打印报价是采购事项，不是 CAD 缺陷。强度、寿命、实际霍尔磁场/阈值、电源瞬态及≤15秒带载开锁均须在样机/台架阶段测量；当前清单不把它们写成已经通过，也不以几何通过替代实测。
