sakura-madoromi/TetherLock/docs/maintenance/validation.md

# 目录治理与 Git/LFS 迁移验收

验证日期：2026-10-04。代码和资源均在原工作区及独立干净检出中检查；干净检出通过本地 Git remote 的 LFS 传输下载对象，没有复制旧 `node_modules`、应用 public、Cargo target 或 Dart 配置。

## 当前资源与提交边界

- 必要二进制集中到 `assets/`：126 个 LFS 文件，约 111.51 MiB；规范二进制不存在相同 SHA-256 的重复副本。
- 清单共登记 133 个资源，包括普通 Git 的文本清单、许可证和快照。两个应用共用 37 个装配网格，25 个打印姿态文件单独维护。
- `generated/`、依赖、缓存和运行副本不被跟踪；旧 Flutter 模拟器与 Dart 模拟器移入本地归档。
- 保留已发布 `main` 的 `95086fa086710571b39ede804c02a39de307ba05`，本地功能和治理变更重建为五个签名提交。未推送、未清洗已发布历史、未执行垃圾回收。

## 已通过的检查

| 验证 | 结果 |
| --- | --- |
| 完整 CAD 导出与几何检查 | 989 项通过；OpenSCAD 2026.10.02 / Manifold |
| 窗栅、铰链、评审运动、参照物、连续安装路径、采购适配 | 31、65、10、33、6、14 项通过 |
| 工程资料、实际剖面与蓝图 | 458 项通过，88 页蓝图，71 个实际剖面路径 |
| CAD / Blueprints / Workbench 交付包 | 403 项通过，含 CRC、源码/文件哈希、嵌套下载包和实际浏览器证据 |
| Web 单元测试与生产构建 | 19 项通过；干净检出也通过 |
| Tauri 前端测试、Svelte/TypeScript 与生产构建 | 8 项通过，0 errors / 0 warnings；干净检出也通过 |
| Rust 核心 | 28 项单元测试与 16 项运行时测试通过；干净检出重新编译后也通过 |
| Dart 协议 | 8 项通过，静态分析无问题；干净检出也通过 |
| Flutter 控制应用 | 29 项通过，静态分析无问题；干净检出也通过 |
| 仓库治理与资源准备 | 3 项 Python 检查测试、5 项资源回归通过；干净检出也通过 |
| 原 Dart 迁移参考 | 26 步输入与冻结参考结果一致，不依赖残留旧实现 |
| 真实 WebKitGTK | 37 个 CAD、800/1280 宽布局、场景/页面重载和暂停核心保留通过 |
| Tauri Rust 构建 | debug 与 custom-protocol 内嵌资源构建通过 |
| Vercel 构建输入 | 规范 LFS ZIP 校验并解包 75 个文件；未部署 |
| Git/LFS | 暂存树及 HEAD 边界检查、LFS 对象/指针检查、补丁检查通过 |
| 恢复材料 | 原工作区备份的 1058 个普通文件逐一校验大小和 SHA-256，包括两个原未跟踪大文件；原 bundle 与 jj 导出补充对象已独立核验 |

浏览器验收覆盖实际网格、图片/GLB/WebM/ZIP 导出、静态子目录、移动布局、完整组装指导、进度恢复、禁用存储和外部请求边界。输出与本机详细日志位于 `generated/` 和 `.local/migration/`，不作为源码提交。

资源准备直接复制已验证工程 JSON 的原始字节，避免 Python/JavaScript 浮点格式差异使哈希失效；该行为有专门回归测试。原生窗口缩放使用仅限定测试应用 PID 的 X11 控制，并使用独立测试数据目录。

上述数字模型与软件检查不改变项目既有的实物验收范围和未解决机械/电气条件；历史证据原文仍保持其原验证日期与含义。
