sakura-madoromi/TetherLock/(commit log)

2026-09-30 feat(init): initialize TetherLock open-source repository
    - OpenSCAD parametric CAD source models (*.scad) and generated production STLs (*.stl)
    - M2 hex socket screw + captive nut servo clamping mechanism
    - Mechanical feasibility audit and system architecture specifications
    - Interactive Three.js Web 3D preview with kinematics and OLED pixel simulation
    - Comprehensive README with BOM, 3D printing guide, and assembly instructions
    [assembly.scad, base_box.scad, base_box.stl, battery_18650.scad, battery_18650.stl, breakaway_latch.scad, breakaway_latch.stl, esp32_c3.scad]
2026-10-02 feat: publish V3 prototype baseline
    [acrylic-1to1.dxf, acrylic.scad, acrylic.stl, assembly.scad, base_box.scad, base_box.stl, base_installed_extra.scad, base_print_extra.scad]
2026-10-03 chore: centralize assets and adopt Git LFS
    Replace tracked exports with ignored generated output and register centralized LFS resources. Preserve published history and all local caches.
    [acrylic-1to1.dxf, acrylic.scad, acrylic.stl, base_box.stl, base_print_extra.stl, battery_connector.stl, battery_hatch.stl, battery_holder.stl]
2026-10-03 refactor: organize mechanical engineering and workbench
    Group V3 CAD, engineering and bench sources under hardware/ and the workbench under apps/. Validate 989 geometry checks, 458 engineering checks and 403 delivery checks.
    [assembly.scad, base_box.scad, base_installed_extra.scad, base_print_extra.scad, blind_roof.scad, continuous_pin_service.scad, electronics.scad, enclosure.scad]
2026-10-03 feat: organize Rust simulator core and Tauri app
    Organize the Rust core and Tauri UI around the shared 37-mesh CAD snapshot. Keep native validation output ignored and support PID-scoped X11 resizing. Validate 44 Rust tests, 8 UI tests, Svelte checks and real WebKit acceptance.
